MatWiecz/AGH-ZSC/README.md

# AGH-ZSC

Source code from laboratories of complex digital systems course. 

# Documentation

Link to documentation (in Polish):

[report2.pdf](report2.pdf)
