MatWiecz/AGH-ZSC/project_schem.pdf

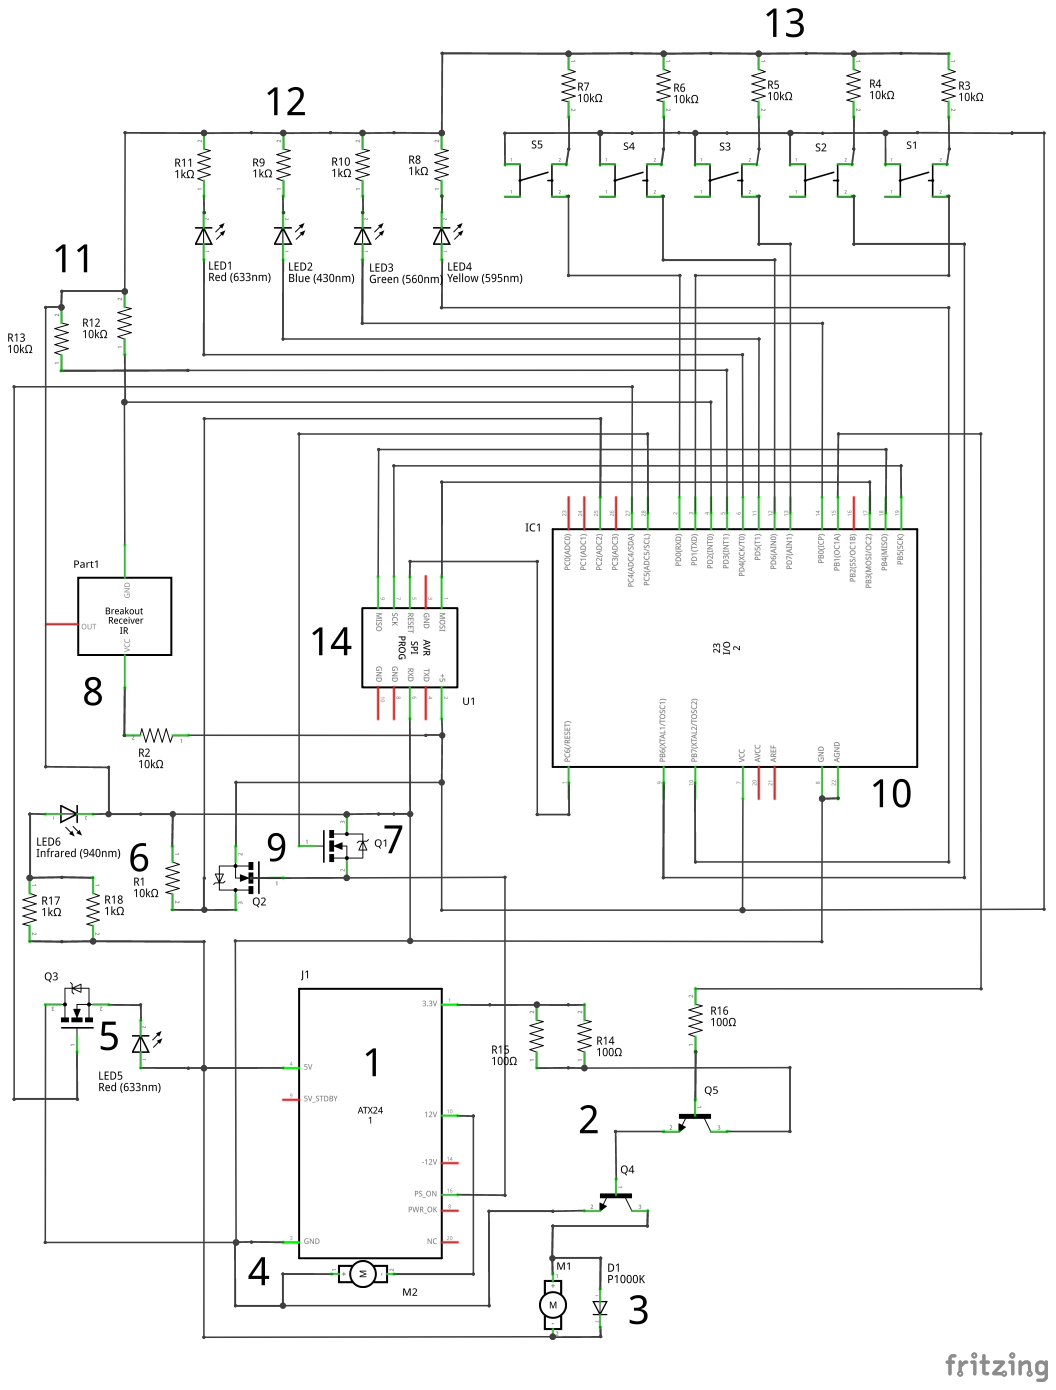
[picture p39: page 1]
