MatWiecz/AGH-ZSC/(list of files, drawings)

Other design files:
project.fzz
